ddstevens/imperium/(threads)

Thread 1 (2022-10-20):

Analog?

thorr2, 2022-10-20:
Hi, I am finally almost done building my arcade cabinet and will soon be building the control panels.  Will this project support analog joystick controls?  I want to make a steering wheel control panel that has a potentiometer for the steeringwheel.

Also, is there a way to integrate/wrap other USB controllers into this somehow so the MiSTer thinks they are all coming in as one controller?  I have USB pedals and it would be cool if they came in on the same device as the steering wheel and shifter.

Thanks!  I am looking forward to trying this with other things like Super Smash TV on the SNES as a single player with two joysticks, and two player arcade games with the same control panel.
